weblaunch/digital-slate/readme.md

# Digital Slate
## Before we dive in

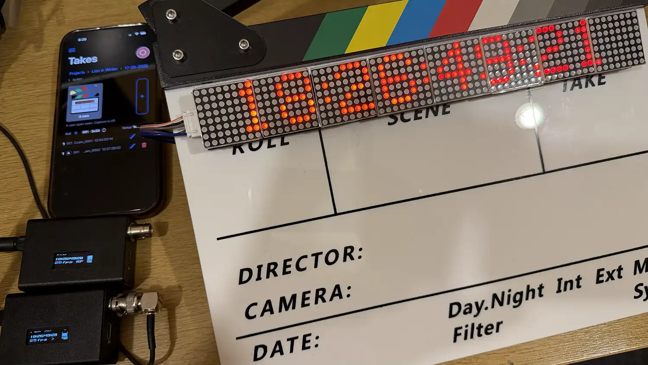
[picture p1: assets/photos/master_slave_slate_app.webp]
Digital Slate master, slave, slate and app


OK, before we get started, some honesty. This idea started with a blog by Jim Mack, and much kudos goes to him. You can read that post here:

[Speed Reading LTC](https://escmdxi.wordpress.com/2022/08/16/speed-reading-ltc/)

I spent a LONG time modifying his sketches but could never get a workable product, probably due to my lack of knowledge truth be told. I gave up.

But each year I run a charity short film project where I spend hours syncing cameras and audio. I've been lucky enough to be on some big budget movies and looked at their tech with envy; I wish I had their toys.

So I returned to my digital slate dream; where I could transmit timecode generated by my Zoom F4 to a digital slate and camera slave and automatically sync everything in Resolve. I quickly realised the simplest way to facilitate and expand on that functionality was to build an app too.

So here I present to you a budget timecode / digital slate project which you can assemble I reckon for about 100GBP (I haven't kept a proper tally, that's a guestimate).

The syncing which used to take me at least 4 hours in Resolve every time can now be done in seconds. Video / Audio synced, renamed by Scene and Take and trimmed at the slate, set-ups gathered into folders labelled by scene.

Now for the honesty. I did VERY little coding on this. AI has had a massive input on this project, but it's still taken me weeks of R&D. I have no doubt there are cleverer people out there than me who could make this better which is why I decided to share under GNU GPLv3.

Even though I've done much of the work, it'll still probably drive you nuts. I had a hell of a job squeezing everything into my enclosures, despite actually laying it all out in 3D first. The app uses the Ionic framework. This is not for the feint-hearted. I will attempt to put it on the App Store at some point so you don't need to compile it yourself.

So please download and play. If you have the talent, help make it better for all of us :-)

Now, over to the AI...

# About

Digital Slate is an open-source film slate ecosystem made of ESP32-based hardware and an Ionic/Angular/Capacitor mobile app. The system is intended to distribute timecode, capture slate open/close events, log production metadata, and later export editorial-friendly metadata for workflows such as DaVinci Resolve.

This repository is the home for the whole project, not just the app. It is intended to contain:

- The Ionic/Angular/Capacitor app.
- Arduino sketches for the ESP32 slate, master, and camera timecode devices.
- Helper tools for editorial workflows, including DaVinci Resolve.
- Hardware notes, build notes, wiring references, and setup documentation.

## Repository Layout

```text
digital-slate/
  src/                         Ionic/Angular app source
  ios/                         Capacitor iOS project
  arduino/
    digital-slate-ble/
      master/                  LTC reader / RF24 transmitter sketch
      slate/                   BLE slate sketch
      slave/                   RF24 receiver / LTC output sketch
  tools/
    resolve/                   DaVinci Resolve Lua helper script
  docs/
    hardware.md                Hardware parts, wiring, and build notes
    setup.md                   End-to-end setup notes
    troubleshooting.md         Known issues and fixes
  assets/
    photos/                    Project and hardware photos
```

## Getting Started

The app can be run locally with:

```bash
npm install
npm start
```

Build the web app with:

```bash
npm run build
```

The hardware firmware and Resolve helper script are kept in their own folders so the app, devices, and editorial tools can be developed together while remaining easy to find.

## Hardware, Firmware, and Resolve Tools

- Arduino sketches live in `arduino/digital-slate-ble/master/`, `arduino/digital-slate-ble/slate/`, and `arduino/digital-slate-ble/slave/`.
- The DaVinci Resolve Lua helper lives in `tools/resolve/digital_slate_resolve_helper.lua`.
- Put hardware documentation, part numbers, wiring notes, and build photos in `docs/hardware.md` and `assets/photos/`.
- Put end-to-end installation and workflow notes in `docs/setup.md`.

The firmware and Resolve helper now live in the repo alongside the app, so the project can be cloned as a complete working set.

## License

Digital Slate is released under the GNU General Public License v3.0 or later. See [LICENSE](LICENSE).

## Project Status

The app now has a basic working structure:

- Project, shoot day, slate, scene, and take navigation.
- SQLite-backed local storage with browser support through `jeep-sqlite` and `sql.js`.
- Reusable slates across shoot days, so camera labels such as `A Cam` do not need to be recreated manually every day.
- Shared scene definitions linked to individual slates.
- Take logging scoped by shoot day, slate, and slate scene.
- Fake slate open/close events that generate timecode from a 09:00:00:00 daily slate start.
- Editable projects, shoot days, slates, scenes, and takes.
- Take flags, including default flags and user-created custom flags.
- Clip name tracking per take, with roll-level auto-increment and rollback on deleted takes.
- Breadcrumb navigation through the hierarchy.
- Search across projects, shoot days, slates, scenes, takes, rolls, media cards, notes, locations, timecode, and flags.

Real Bluetooth connection is the next major integration point.

## Hardware Overview

The wider system consists of:

1. A master device that reads LTC timecode from a recorder.
2. One or more slate devices that display timecode and physically clap.
3. One or more camera slave devices that receive RF timecode and output LTC.
4. The Ionic/Capacitor app, which will communicate with slates over Bluetooth.

Primary MCU:

- Adafruit Feather ESP32-S3

RF module:

- NRF24L01 using the RF24 library.

Known stable RF pins:

```cpp
#define RF24_CE_PIN 13
#define RF24_CSN_PIN 12
```

The RF24 module and MAX7219 matrix should use separate SPI buses where possible. Sharing one SPI bus between RF and matrix display has proven unreliable.

## Slate Hardware Notes

Slate display hardware:

- MAX7219 FC16_HW LED matrix modules, 8 devices chained.
- SH1106 or SSD1306 OLED display.

Current matrix pins:

```cpp
#define MATRIX_DATA_PIN 17
#define MATRIX_CLK_PIN 18
#define MATRIX_CS_PIN 16
```

Known OLED address:

```cpp
0x3C
```

Hall sensor:

- Used to detect slate open/close.
- DRV5032 tested.
- Allegro A1120EUA-T also under consideration.

Current hall pin:

```cpp
#define HALL_PIN 5
```

Slate behavior:

- Open state is represented by `<`.
- Closed state is represented by `=`.
- When the slate closes, the displayed timecode freezes and the close frame is captured.
- The app currently mirrors these events with fake open/close buttons.

Current defaults:

```cpp
#define DEFAULT_MATRIX_INTENSITY 3
#define DEFAULT_SLEEP_SECONDS 5
#define DEFAULT_FRAME_OFFSET 1
```

## Timecode

The production timecode scheme follows actual time. In normal use the slate is set to:

```text
09:00:00:00
```

in the morning and then runs all day.

The app fake slate event generator mirrors this behavior at 25fps. It derives current fake timecode from a 09:00 daily start rather than starting from zero when the app opens.

## App Stack

Current stack:

- Ionic
- Angular
- Capacitor
- `@capacitor-community/sqlite`
- `jeep-sqlite` for browser development
- `sql.js@1.11.0` with `src/assets/sql-wasm.wasm`

Capacitor app id:

```text
com.weblaunchuk.digitalslate
```

Useful commands:

```bash
npm start
npm run build
```

`npm run build` currently completes successfully. The build may show a non-blocking `jeep-sqlite` warning about the Node `crypto` module.

## App Navigation

Current app hierarchy:

```text
Projects
  -> Shoot Days
    -> Slates
      -> Scenes
        -> Takes
```

Current side menu:

```text
Projects
Search
Export
Slate Connection
Settings
```

Export, connection, and settings screens are placeholders or future work areas.

The Search screen supports:

- Free-text search.
- Type filtering for scenes, takes, flags, days, slates, and projects.
- Optional flag filtering.
- Deep links back into the relevant hierarchy page.

## Data Model

### Project

Stores production-level metadata:

- name
- director
- dop
- camera_op

### Shoot Day

Stores day-level metadata:

- date
- location

Human-readable dates in the UI should use:

```text
DD-MM-YYYY
```

Stored dates remain ISO-style strings where useful for sorting and database work.

### Slate

Represents a camera slate, such as:

```text
A Cam
B Cam
```

Slates can be reused across shoot days. When adding a slate, the app should offer existing project slates first, with an option to create a new slate.

### Scene

Stores shared scene metadata:

- scene_name
- location
- time_of_day
- notes

Scene records are shared definitions. Editing a scene updates all linked slate scenes.

### Slate Scene

Join between a slate and a shared scene.

Purpose:

- Allow one scene to appear on multiple slates.
- Preserve separate takes per camera/slate.

### Media Card

Represents a reusable physical recording card, such as:

```text
SxS 01
SxS 02
```

Cards are reusable inventory. They can be assigned to many rolls over time.

### Roll

Represents a named recording roll for a project, optionally tied to a reusable media card.

Important fields:

- project_id
- shoot_day_id
- slate_id
- card_id
- roll_name
- last_clip_name
- notes

This allows a small pool of physical cards to be reused while preserving roll metadata per project/day/slate.
The app can use `last_clip_name` to suggest the next camera file name for takes on the roll.

### Take

Takes belong to a slate scene and are also tied to their shoot day and slate.

Important fields:

- shoot_day_id
- slate_id
- slate_scene_id
- roll_id
- clip_name
- take_number
- slate_open_timecode
- slate_close_timecode
- notes

Take uniqueness is scoped by:

```text
shoot_day_id + slate_id + slate_scene_id + take_number
```

This prevents takes from previous days or other camera slates being confused with the current day.

### Flags

Flags are stored in a lookup table and linked to takes through a join table.

Default flags:

- Good
- Bad
- Circle
- False start
- Boom visible
- Focus issue
- Sound issue

Users can also add their own flags from the take modal.

## Bluetooth Plan

The app has fake slate events and a BLE event source. Fake and real events flow through the same app-side handling so open and close events create/update takes in the current active Takes page.

App-side BLE abstraction:

```ts
SlateBleService
  request_and_connect()
  disconnect()
  events$
  status$
```

The BLE service subscribes to notifications and emits the same internal event shape as fake events.

BLE UUIDs:

```text
Service:              7b2f0001-8f4b-4c71-9a0c-0d151a7e0001
Event characteristic: 7b2f0002-8f4b-4c71-9a0c-0d151a7e0001
```

The physical slate is not expected to transmit app metadata such as:

- slate_id
- camera
- scene
- take_number

The app should infer those from the active app context or from a stored device-to-slate mapping.

Physical BLE devices can be bound to app slates from the Takes page. The app stores the BLE `device_id` and optional device name on the slate record. When a slate has a binding, incoming BLE events from other devices are ignored for that Takes page to avoid logging takes against the wrong camera.

BLE notifications should use JSON. Minimal useful payloads:

```json
{ "type": "open", "timecode": "09:14:22:03" }
{ "type": "close", "timecode": "09:14:27:11" }
```

The app normalizes those into internal events with:

```ts
{
  event_type: 'open' | 'close',
  device_id: string,
  reported_device_id?: string,
  timecode: string,
  received_at: string
}
```

`device_id` is the BLE connection identifier from iOS/Capacitor and is what the app uses for binding a physical device to an app slate. A JSON `device_id` sent by the slate is kept as `reported_device_id` for diagnostics, but it is not used for app-side routing.

Optional JSON fields can be added without changing the core event flow:

```json
{
  "type": "close",
  "device_id": "slate-a",
  "timecode": "09:14:27:11",
  "sent_at": "2026-05-14T09:14:27.440Z",
  "battery_voltage": 7.40,
  "orientation": "upright"
}
```

The app also accepts `orientation: "inverted"` or `inverted: true`, `1`, or `"1"`. An inverted close event automatically applies the `End Slate` flag to the take. End-slate takes are exported without a trim-out timecode.

The parser also accepts `slate_opened` and `slate_closed` as aliases for `open` and `close`.

The slate may publish an initial ready message so the characteristic has a harmless readable value before the first real event:

```json
{ "type": "ready", "device_id": "slate-a", "battery_voltage": 7.40 }
```

The app accepts and ignores this as a take event, while logging that the slate is ready.

## Capture Workflow

Scenes are managed at shoot-day level. A scene can allocate only the slates that are rolling for that scene, so A Cam and B Cam can be included independently.

The Takes page is scene-first and shows one tab per allocated slate. Each tab shows the slate label, connected/disconnected state, open/closed state, and an `ion-badge` count for takes captured while that slate tab was inactive.

The operator uses a single scene-level Capture button. BLE open and close events are ignored unless Capture is active. Once the app receives a close event for a captured take, Capture is automatically disabled.

First real BLE milestone:

1. Scan for slate devices.
2. Connect to one slate.
3. Receive open and close notifications.
4. Convert notifications into the same event stream as fake events.
5. Open and close takes in the current active slate scene.

## Future Work

Near-term app work:

- Device-to-slate mapping.
- Connection status and reconnect handling.

Later app work:

- DaVinci Resolve friendly exports.
- Clip naming helpers.
- Marker generation.
- Metadata sync.
- Multicam workflow helpers.

ESP32 Bluetooth work:

- BLE service.
- BLE characteristics.
- Open/close notification protocol.
- Battery/status notifications.
- Reconnection behavior.

## Coding Notes

Project style preferences:

- Prefer snake_case in app code.
- Keep data structured in SQLite rather than nested JSON blobs.
- Use Capacitor Preferences only for app settings, connection settings, and user preferences.
- Avoid placeholders where complete working code can be written.
